Armastardo/QS-09/Case/qs-09_bottom.stl

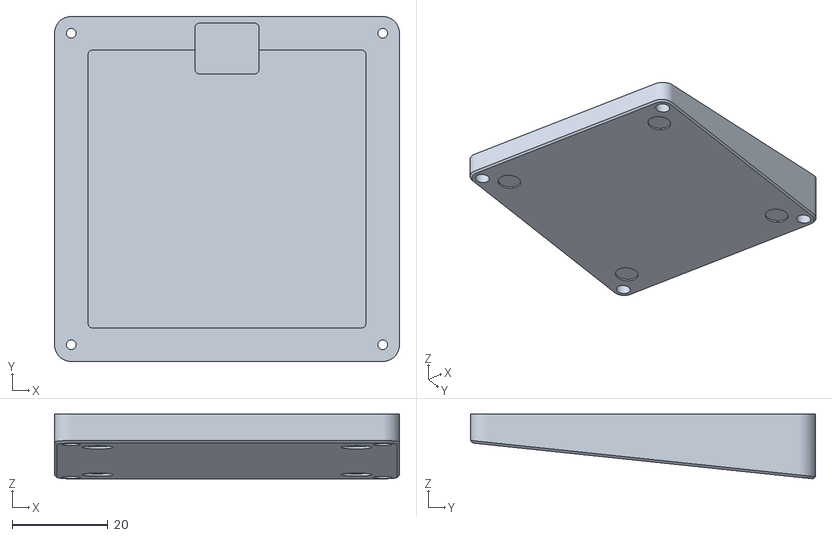
[picture p1: CAD file, 2022-06-30]
Case/qs-09_bottom.stl
72.1 x 72.1 x 13.5
