Armastardo/QS-09/plate_qs09.dxf

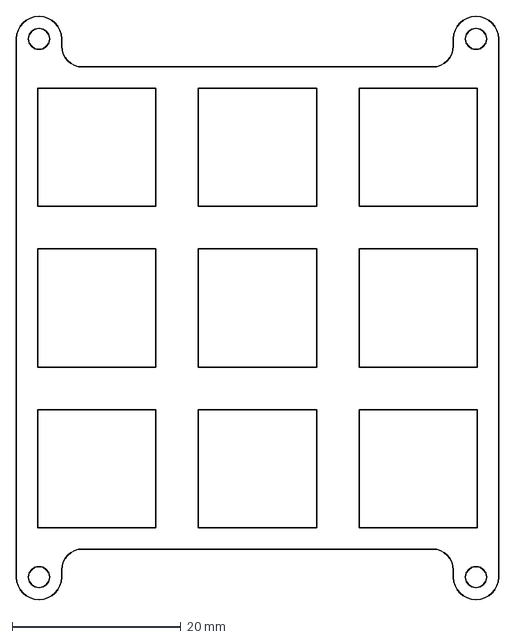
[picture p2: CAD file, 2022-02-02]
plate_qs09.dxf
57.2 x 69.1 mm
