Armastardo/QS-09/Case/qs-09_top.stl

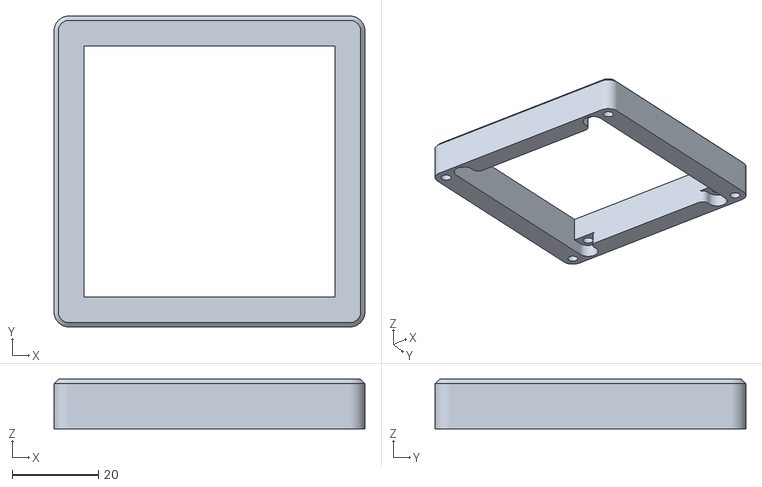
[picture p3: CAD file, 2022-06-30]
Case/qs-09_top.stl
72.1 x 72.1 x 11.5
