Armastardo/QS-09/(list of files, cad)

Other CAD files:
Case/QS-09_v11.f3z
