Armastardo/QS-09/QS-09.kicad_pcb

## KiCad design QS-09.kicad_pcb (2022-02-02)

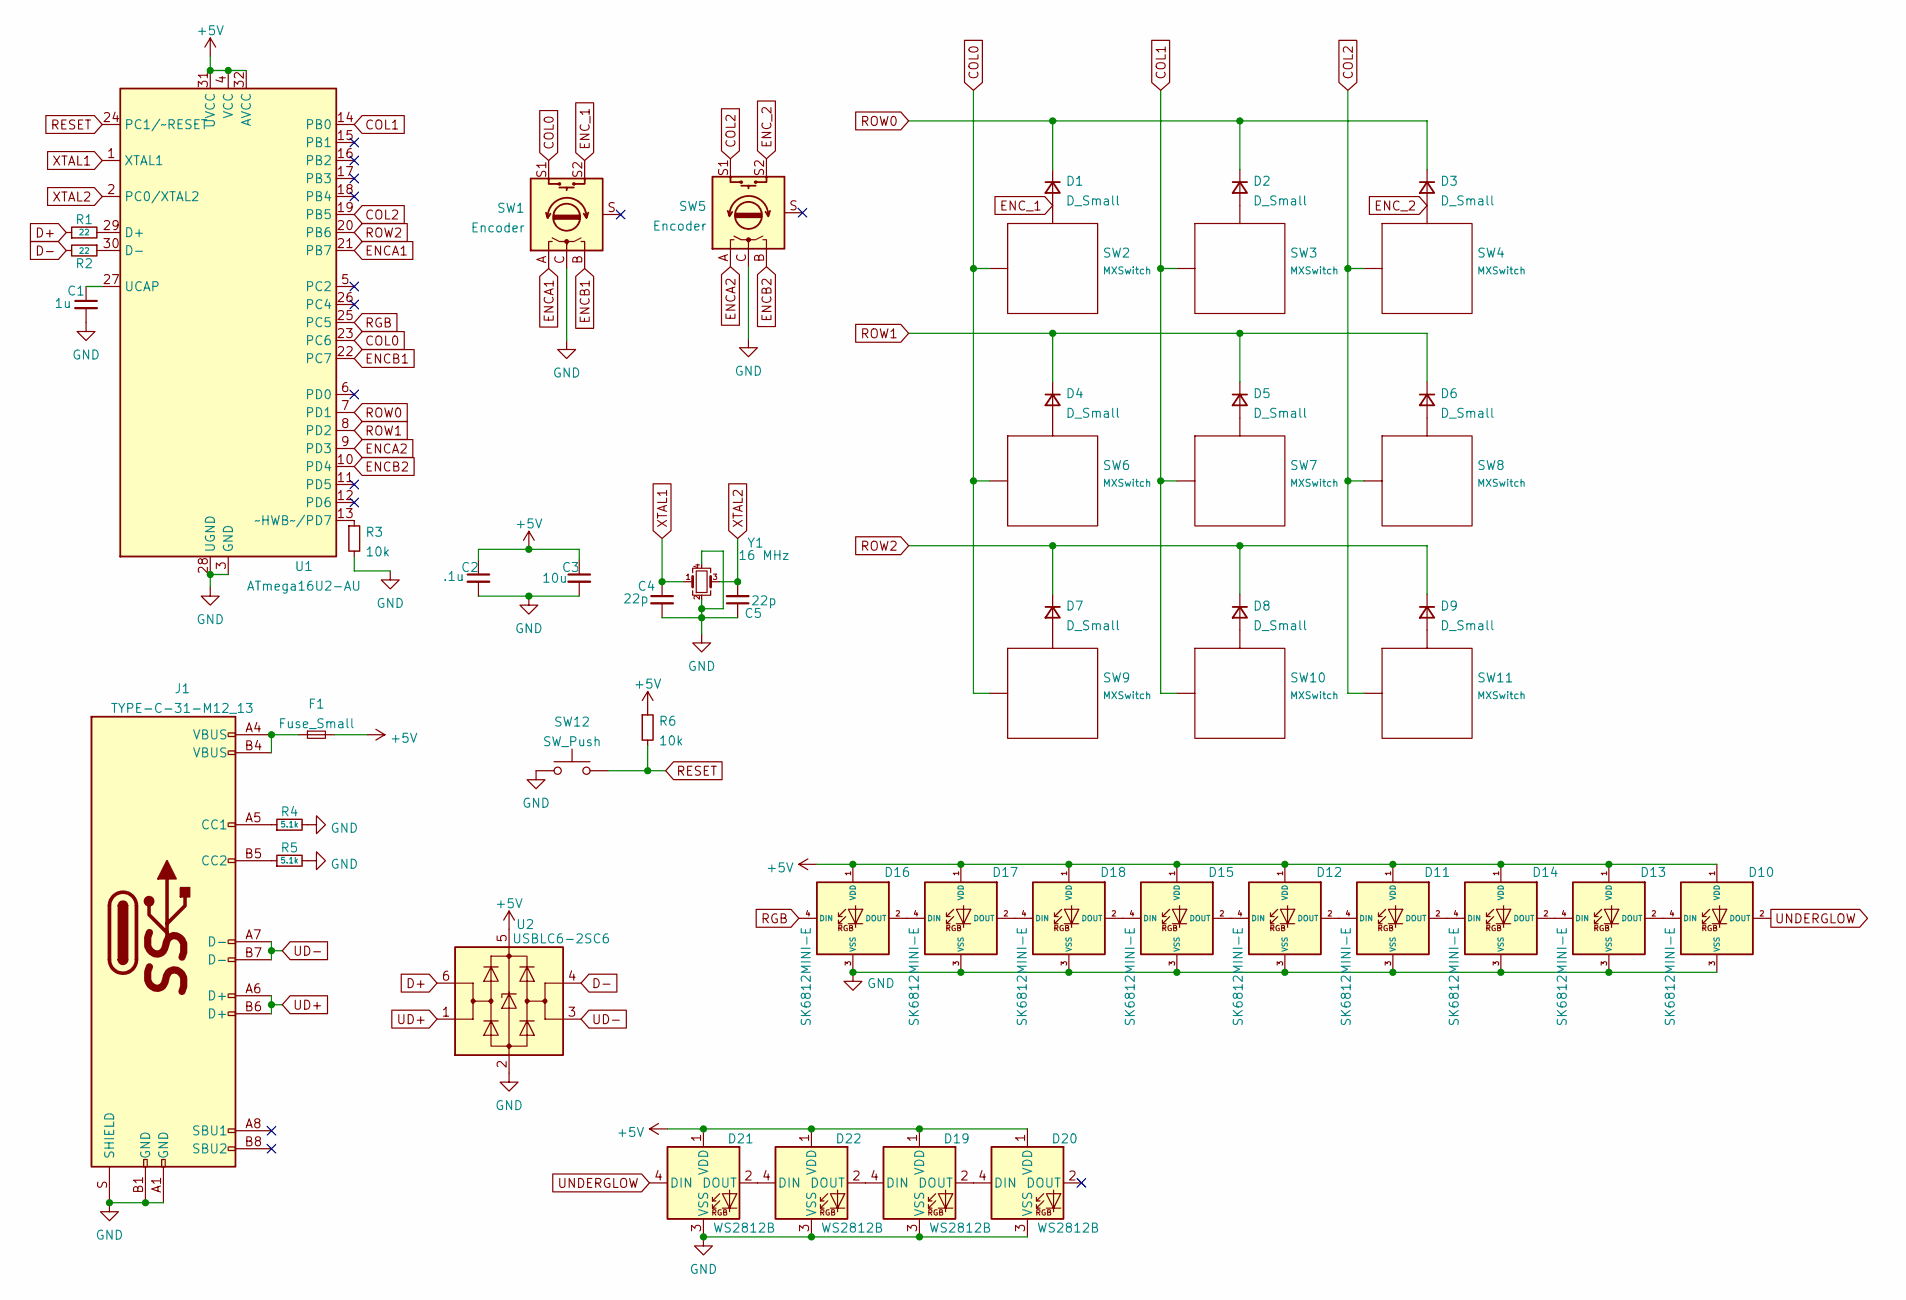
[picture p4: schematic QS-09.kicad_sch]

Parts:
C1: 1u; C_0603_1608Metric
C2: .1u; C_0603_1608Metric
C3: 10u; C_0603_1608Metric
C4, C5: 22p; C_0603_1608Metric
D1, D2, D3, D4, D5, D6, D7, D8, D9: D_Small; D_SOD-123
D10, D11, D12, D13, D14, D15, D16, D17, D18: SK6812MINI-E; SK6812MINI_3535_6028_3.2x2.8mm_Round; MPN SK812MINI-E
D19, D20, D21, D22: WS2812B; LED_WS2812B_PLCC4_5.0x5.0mm_P3.2mm
F1: Fuse_Small; Fuse_1206_3216Metric
J1: TYPE-C-31-M12_13; TYPE-C-31-M-12
R1, R2: 22; R_0603_1608Metric
R3, R6: 10k; R_0603_1608Metric
R4, R5: 5.1k; R_0603_1608Metric
SW1, SW5: Encoder; RotaryEncoder_Alps_EC11E-Switch_Vertical_H20mm
SW2, SW3, SW4, SW6, SW7, SW8, SW9, SW10, SW11: MXSwitch; MX100
SW12: SW_Push; SW_SPST_SKQG_WithStem
U1: ATmega16U2-AU; TQFP-32_7x7mm_P0.8mm
U2: USBLC6-2SC6; SOT-23-6
Y1: 16 MHz; Crystal_SMD_3225-4Pin_3.2x2.5mm

Connections:
+5V: C2.1, C3.1, D10.1 (VDD), D11.1 (VDD), D12.1 (VDD), D13.1 (VDD), D14.1 (VDD), D15.1 (VDD), D16.1 (VDD), D17.1 (VDD), D18.1 (VDD), D19.1 (VDD), D20.1 (VDD), D21.1 (VDD), D22.1 (VDD), F1.2, R6.1, U1.4 (VCC), U1.31 (UVCC), U1.32 (AVCC), U2.5 (VBUS)
COL0: SW1.S1, SW2.1 (Col), SW6.1 (Col), SW9.1 (Col), U1.23 (PC6)
COL1: SW3.1 (Col), SW7.1 (Col), SW10.1 (Col), U1.14 (PB0)
COL2: SW4.1 (Col), SW5.S1, SW8.1 (Col), SW11.1 (Col), U1.19 (PB5)
D+: R1.1, U2.6 (I/O1)
D-: R2.2, U2.4 (I/O2)
ENCA1: SW1.A, U1.21 (PB7)
ENCA2: SW5.A, U1.9 (PD3)
ENCB1: SW1.B, U1.22 (PC7)
ENCB2: SW5.B, U1.10 (PD4)
ENC_1: D1.2 (A), SW1.S2, SW2.2 (Row)
ENC_2: D3.2 (A), SW4.2 (Row), SW5.S2
GND: C1.2, C2.2, C3.2, C4.2, C5.1, D10.3 (VSS), D11.3 (VSS), D12.3 (VSS), D13.3 (VSS), D14.3 (VSS), D15.3 (VSS), D16.3 (VSS), D17.3 (VSS), D18.3 (VSS), D19.3 (VSS), D20.3 (VSS), D21.3 (VSS), D22.3 (VSS), J1.A1 (GND), J1.B1 (GND), J1.S (SHIELD), R3.2, R4.2, R5.2, SW1.C, SW5.C, SW12.1, U1.3 (GND), U1.28 (UGND), U2.2 (GND), Y1.2, Y1.4
unnamed: C1.1, U1.27 (UCAP)
unnamed: D2.2 (A), SW3.2 (Row)
unnamed: D4.2 (A), SW6.2 (Row)
unnamed: D5.2 (A), SW7.2 (Row)
unnamed: D6.2 (A), SW8.2 (Row)
unnamed: D7.2 (A), SW9.2 (Row)
unnamed: D8.2 (A), SW10.2 (Row)
unnamed: D9.2 (A), SW11.2 (Row)
unnamed: D10.4 (DIN), D13.2 (DOUT)
unnamed: D11.2 (DOUT), D14.4 (DIN)
unnamed: D11.4 (DIN), D12.2 (DOUT)
unnamed: D12.4 (DIN), D15.2 (DOUT)
unnamed: D13.4 (DIN), D14.2 (DOUT)
unnamed: D15.4 (DIN), D18.2 (DOUT)
unnamed: D16.2 (DOUT), D17.4 (DIN)
unnamed: D17.2 (DOUT), D18.4 (DIN)
unnamed: D19.2 (DOUT), D20.4 (DIN)
unnamed: D19.4 (DIN), D22.2 (DOUT)
unnamed: D21.2 (DOUT), D22.4 (DIN)
unnamed: F1.1, J1.A4 (VBUS), J1.B4 (VBUS)
unnamed: J1.A5 (CC1), R4.1
unnamed: J1.B5 (CC2), R5.1
unnamed: R1.2, U1.29 (D+)
unnamed: R2.1, U1.30 (D-)
unnamed: R3.1, U1.13 (~HWB~/PD7)
RESET: R6.2, SW12.2, U1.24 (PC1/~RESET)
RGB: D16.4 (DIN), U1.25 (PC5)
ROW0: D1.1 (K), D2.1 (K), D3.1 (K), U1.7 (PD1)
ROW1: D4.1 (K), D5.1 (K), D6.1 (K), U1.8 (PD2)
ROW2: D7.1 (K), D8.1 (K), D9.1 (K), U1.20 (PB6)
UD+: J1.A6 (D+), J1.B6 (D+), U2.1 (I/O1)
UD-: J1.A7 (D-), J1.B7 (D-), U2.3 (I/O2)
UNDERGLOW: D10.2 (DOUT), D21.4 (DIN)
XTAL1: C4.1, U1.1 (XTAL1), Y1.1
XTAL2: C5.2, U1.2 (PC0/XTAL2), Y1.3

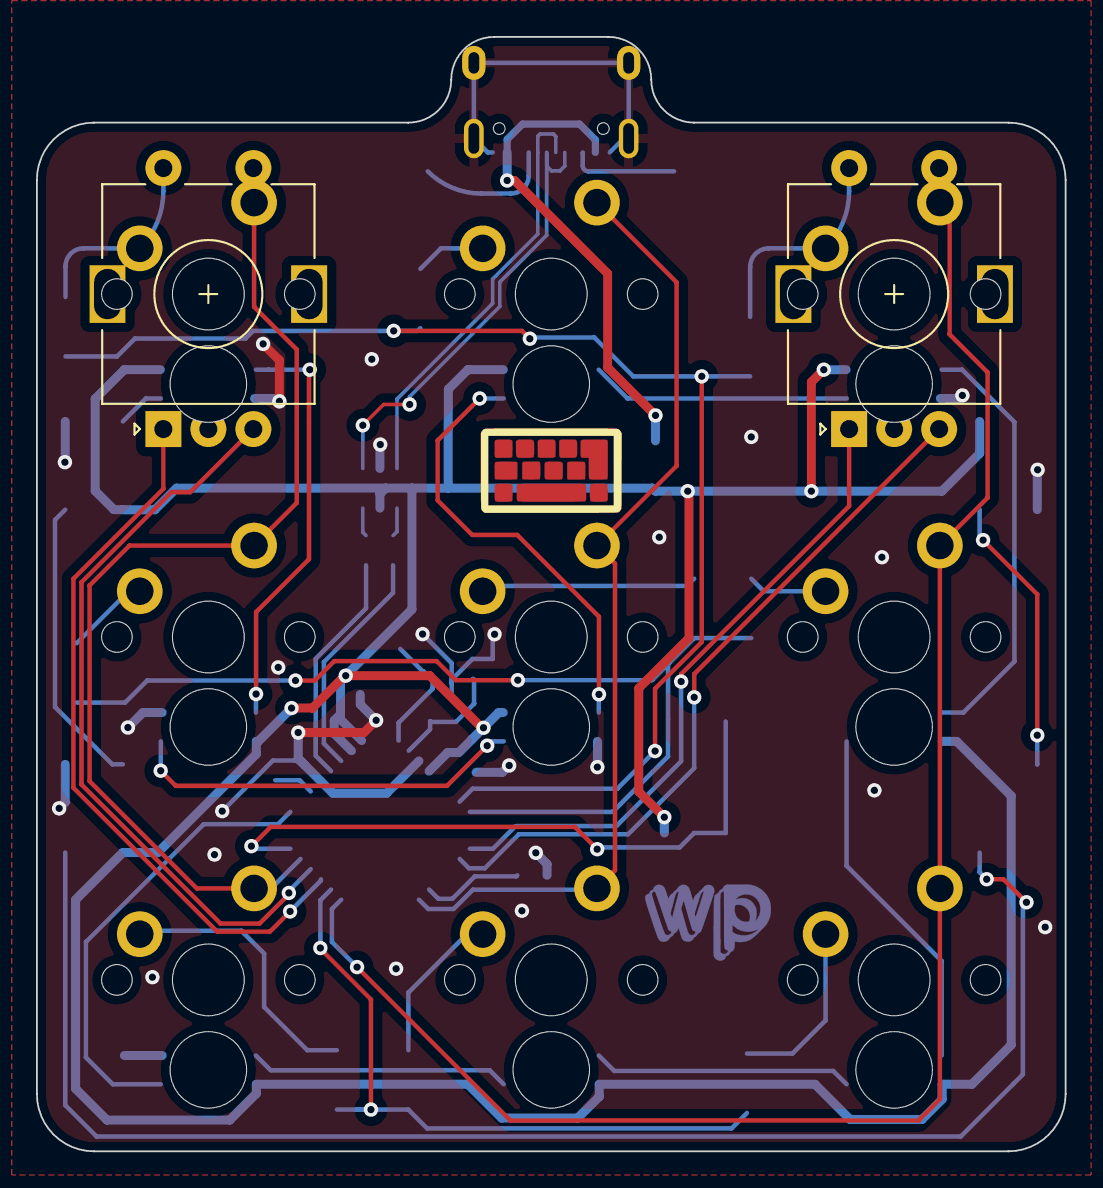
[picture p5: board QS-09.kicad_pcb from above]

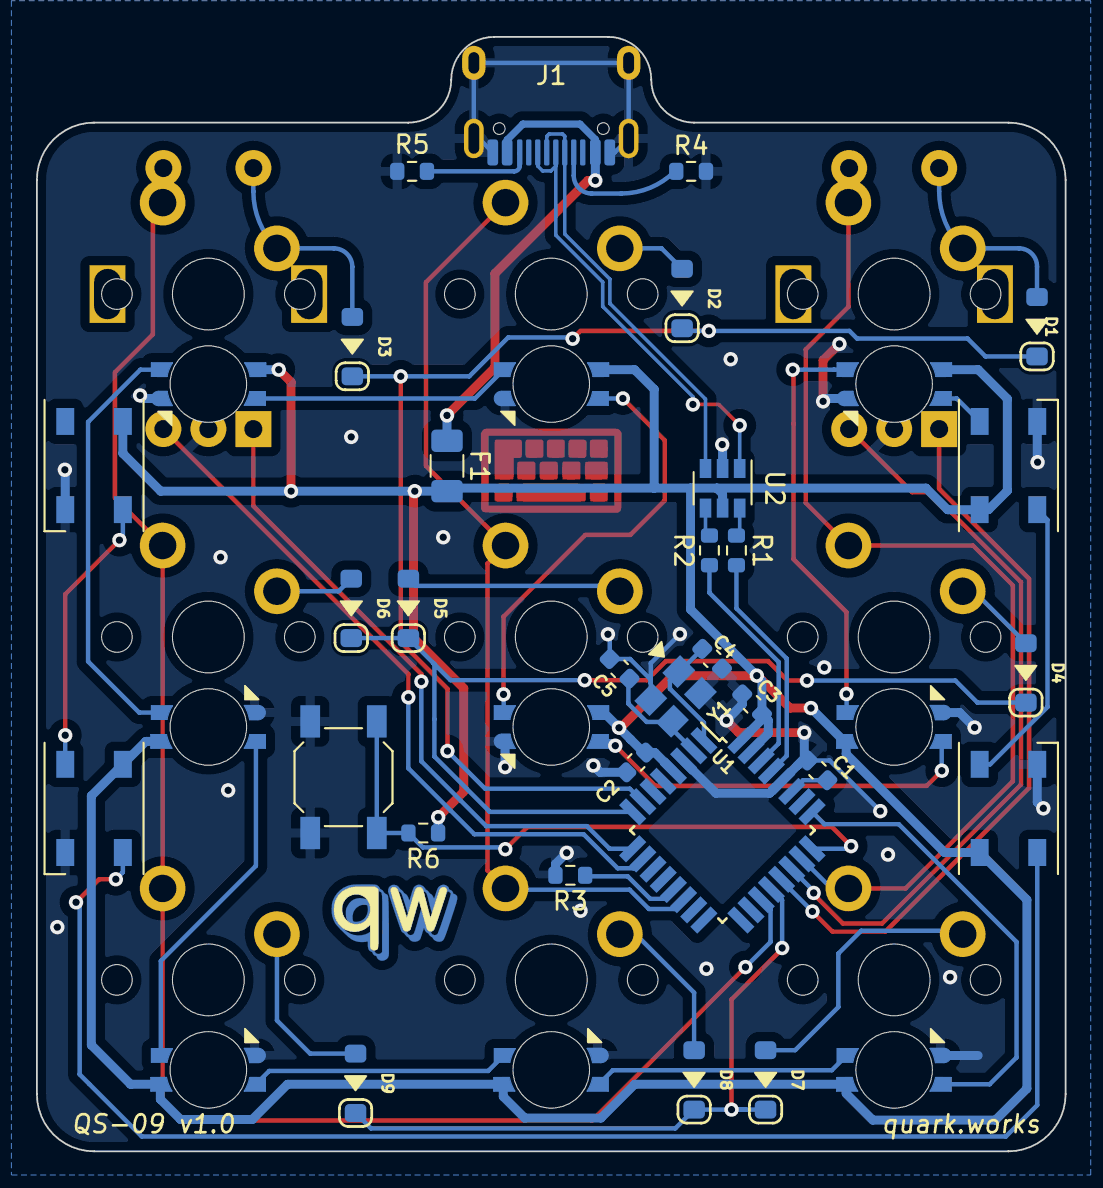
[picture p6: board QS-09.kicad_pcb from below]

Board: 2 copper layers, 57.2 x 61.9 mm, 52 parts (49 on the bottom side), 48 nets.

Other parts of the board:
Ref**: Val**; iso
Ref**#2: Val**; qw-logo-small
