Armastardo/QS-09/(commit log)

2021-08-09 Pre routing
    [QS-09.kicad_pcb, QS-09.kicad_sch]
2021-08-09 USB ready, fixed RGB
    [QS-09.kicad_pcb, QS-09.kicad_sch]
2021-09-05 Added reset button, fixed a missing resistor
    [QS-09-B_Cu.gbr, QS-09-B_Mask.gbr, QS-09-B_Paste.gbr, QS-09-B_Silkscreen.gbr, QS-09-Edge_Cuts.gbr, QS-09-F_Cu.gbr, QS-09-F_Mask.gbr, QS-09-F_Paste.gbr]
2021-11-12 Fixed some wonky shit with the data lines
    [QS-09.kicad_pcb, QS-09.kicad_sch]
2021-12-31 Ready for production
    [QS-09-B_Cu.gbr, QS-09-B_Mask.gbr, QS-09-B_Paste.gbr, QS-09-B_Silkscreen.gbr, QS-09-Edge_Cuts.gbr, QS-09-F_Cu.gbr, QS-09-F_Mask.gbr, QS-09-F_Paste.gbr]
2022-02-02 New logo, version 1.0
    [QS-09-B_Cu.gbr, QS-09-B_Mask.gbr, QS-09-B_Paste.gbr, QS-09-B_Silkscreen.gbr, QS-09-Edge_Cuts.gbr, QS-09-F_Cu.gbr, QS-09-F_Mask.gbr, QS-09-F_Paste.gbr]
2022-06-30 Added case
    [QS-09_v11.f3z, qs-09_bottom.stl, qs-09_top.stl]
